umartinkus/Record-Player/(list of files, drawings)

Other design files:
Simulation/OPA164x/OPA164x.OLB
Simulation/OPA164x/OPA164x_Test_Circuit.DSN
Simulation/OPA164x/OPA164x_Test_Circuit.OPJ
