umartinkus/Record-Player/(commit log)

2026-08-04 removed LM741
    updating circuit strucutre
2026-08-08 renamed matlab processing folder
    [InputNoise.csv, T01.csv, inputAmpOff.csv, inputNoiseAmpOff.csv, outputAmpOff.csv, outputNoise.csv, outputNoiseAmpOff.csv]
2026-08-08 project cleanup
    [BodePlot - 04.28.2025.csv]
2026-08-09 prelim BOM and SPICE files added
    [bom_draft.csv]
2026-08-09 got rid of IEC ammendment pole @20Hz. Docs say that it doesn't make a big difference
2026-08-20 fixed power sims by setting PGND -> 0
2026-08-28 added OPA model to RIAA amp; updated sys models
    [OPA164x.OLB, OPA164x_Test_Circuit.DSN, OPA164x_Test_Circuit.OPJ]
2026-08-28 made txt for transient sim of power rails
